TigoG/Minor_Smart_Things/design/architecture/ArchitectureDesign/Architecture Design.png

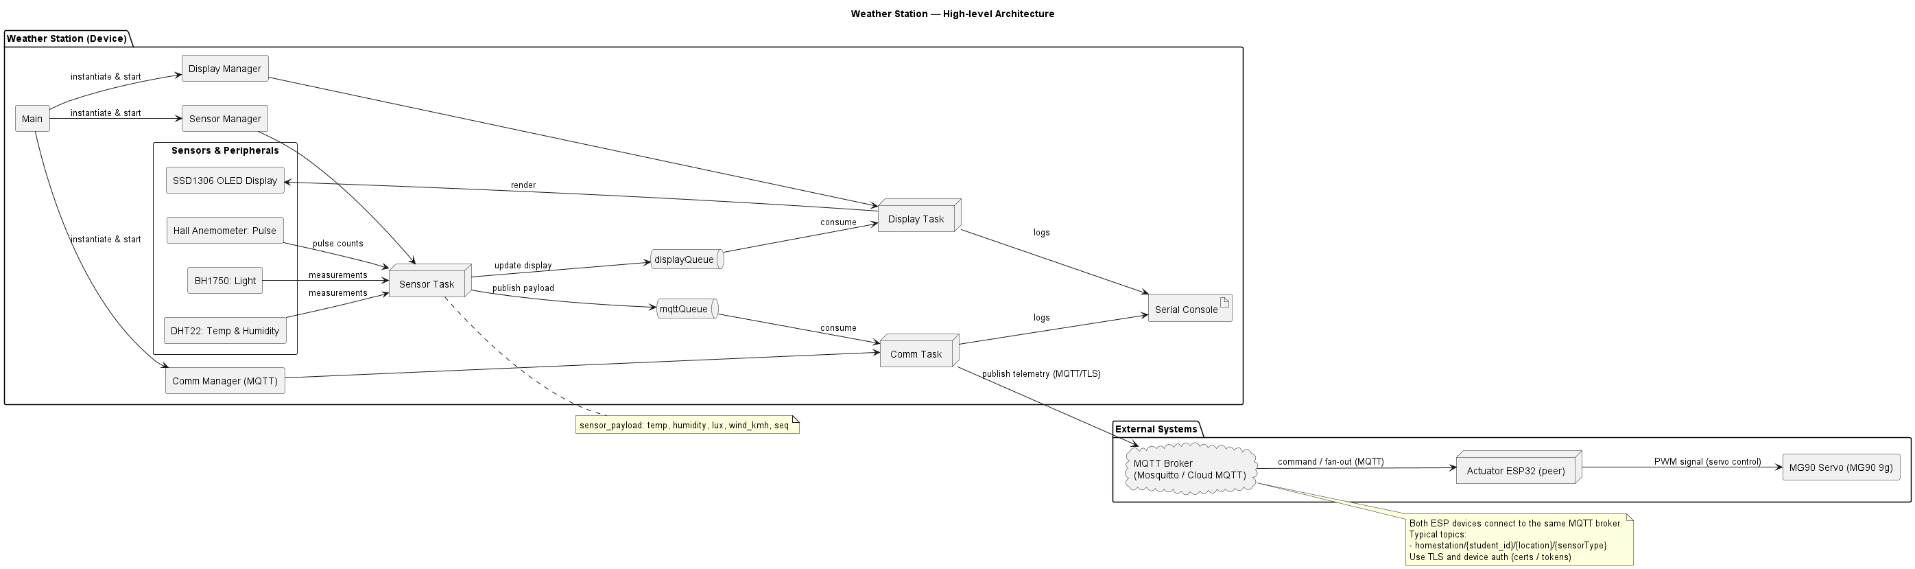
design/architecture/ArchitectureDesign/Architecture Design.png
