TigoG/Minor_Smart_Things/out/design/architecture/ArchitectureDesign/Architecture Design.png

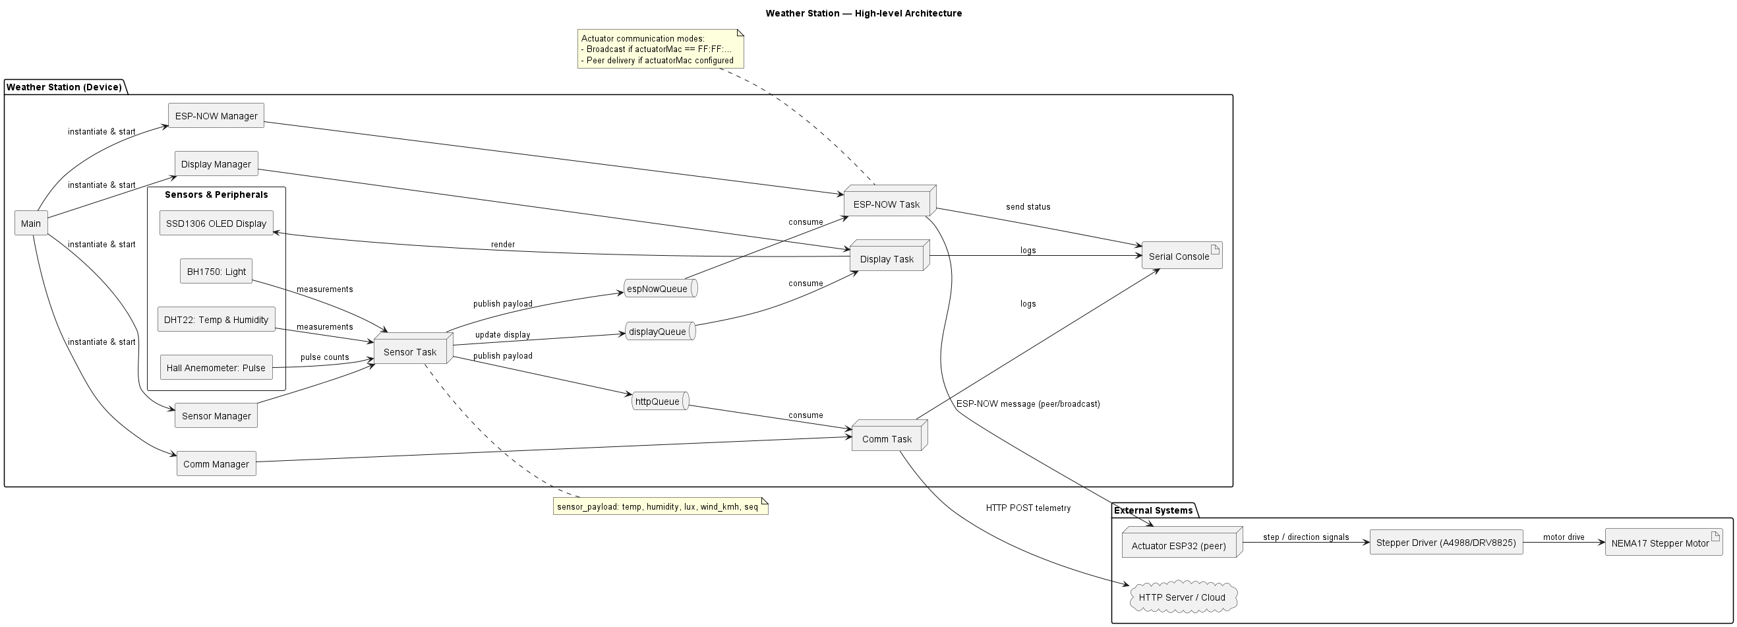
out/design/architecture/ArchitectureDesign/Architecture Design.png
