TigoG/Minor_Smart_Things/weatherStation/src/managers/SensorManager.cpp

#include "SensorManager.h"
#include "Common.h"
#include <Arduino.h>
#include <cmath>
#include <Wire.h>
#include <BH1750.h>
#include <freertos/FreeRTOS.h>
#include <freertos/task.h>

//
// Local ISR state (kept private to this translation unit)
//
volatile uint32_t pulseCount = 0;
volatile uint32_t lastPulseMicros = 0;

IRAM_ATTR void hallISR() {
  uint32_t now = micros();
  if (now - lastPulseMicros > 1000) {
    pulseCount++;
    lastPulseMicros = now;
  }
}

static BH1750 lightMeter;

SensorManager::SensorManager(uint32_t intervalMs)
  : _intervalMs(intervalMs), _seq(0) {}

void SensorManager::begin() {
  Wire.begin(SDA_PIN, SCL_PIN);

  // Scan I2C for BH1750 on common addresses (0x23 and 0x5C) and attempt init.
  Serial.println("Scanning I2C for BH1750...");
  uint8_t candidate_addrs[] = { BH1750_ADDR, 0x5C };
  uint8_t foundAddr = 0;
  size_t naddrs = sizeof(candidate_addrs) / sizeof(candidate_addrs[0]);
  for (size_t i = 0; i < naddrs; ++i) {
    uint8_t addr = candidate_addrs[i];
    Wire.beginTransmission(addr);
    uint8_t ack = Wire.endTransmission();
    if (ack == 0) {
      Serial.printf("I2C device responds at 0x%02X\n", addr);
      foundAddr = addr;
      break;
    } else {
      Serial.printf("No I2C ack at 0x%02X (err=%d)\n", addr, ack);
    }
  }

  bool bhOk = false;
  if (foundAddr) {
    // Pass explicit address and Wire instance to the BH1750 library to avoid address ambiguity.
    bhOk = lightMeter.begin(BH1750::ONE_TIME_HIGH_RES_MODE, foundAddr, &Wire);
    if (bhOk) {
      Serial.printf("BH1750 init OK at 0x%02X (one-shot)\n", foundAddr);
    } else {
      Serial.printf("BH1750 init failed at 0x%02X\n", foundAddr);
    }
  } else {
    // Try default address from Common.h, then library default as fallback.
    if (lightMeter.begin(BH1750::ONE_TIME_HIGH_RES_MODE, BH1750_ADDR, &Wire)) {
      Serial.printf("BH1750 init OK at default addr 0x%02X\n", BH1750_ADDR);
      bhOk = true;
    } else if (lightMeter.begin(BH1750::ONE_TIME_HIGH_RES_MODE)) {
      Serial.println("BH1750 init OK (library default)");
      bhOk = true;
    } else {
      Serial.println("BH1750 init failed (no BH1750 found)");
    }
  }

  delay(200);

  // DHT22 handled by manual bit-banged reader; no library init required
  pinMode(HALL_PIN, INPUT_PULLUP);
  attachInterrupt(digitalPinToInterrupt(HALL_PIN), hallISR, FALLING);

  if (!espNowQueue) espNowQueue = xQueueCreate(5, sizeof(sensor_payload_t));
  if (!httpQueue) httpQueue = xQueueCreate(5, sizeof(sensor_payload_t));
  if (!displayQueue) displayQueue = xQueueCreate(1, sizeof(sensor_payload_t));

  xTaskCreatePinnedToCore(&SensorManager::taskEntry, "SensorTask", 4096, this, 2, NULL, 1);
}

void SensorManager::taskEntry(void* pv) {
  static_cast<SensorManager*>(pv)->task();
}

void SensorManager::task() {
  for (;;) {
    uint32_t start = millis();

    noInterrupts();
    uint32_t pulses = pulseCount;
    pulseCount = 0;
    interrupts();

    // Use pulses per second and apply calibration to convert to km/h:
    // Calibration (logarithmic fit from calibration curve):
    //   wind_kmh = 6.4056 * ln(pulses_per_sec) + 10.212   (R^2 = 0.9914)
    float pulses_per_sec = (float)pulses / (_intervalMs / 1000.0f);
    float wind_kmh;
    // Treat tiny pulse rates as zero (noise floor)
    if (pulses_per_sec < 0.05f) {
      wind_kmh = 0.0f;
    } else {
      // Use natural logarithm; clamp negative results to zero
      float fitVal = 6.4056f * logf(pulses_per_sec) + 10.212f;
      wind_kmh = (fitVal > 0.0f) ? fitVal : 0.0f;
    }
    // Legacy physical conversion (kept as reference):
    // const float PI_f = 3.14159265358979323846f;
    // float linear_speed_m_s = (pulses_per_sec / (float)PULSES_PER_REV) * (2.0f * PI_f * ANEMOMETER_RADIUS_M);
    // float wind_kmh = linear_speed_m_s * 3.6f;
    
    float tempC, humidity;
    if (!readDHT22(tempC, humidity)) {
      tempC = NAN;
      humidity = NAN;
    }
    float lux = readLuxBH1750();
    
    sensor_payload_t payload;
    payload.tempC = tempC;
    payload.humidity = humidity;
    payload.lux = lux;
    payload.wind_kmh = wind_kmh;
    payload.seq = ++_seq;

    Serial.printf("Sensor: seq=%u temp=%0.1f hum=%0.1f wind=%0.2f km/h lux=%0.1f\n",
                  payload.seq,
                  isnan(payload.tempC) ? NAN : payload.tempC,
                  isnan(payload.humidity) ? NAN : payload.humidity,
                  payload.wind_kmh,
                  isnan(payload.lux) ? NAN : payload.lux);

    // Publish to queues (non-blocking)
    if (espNowQueue) xQueueSend(espNowQueue, &payload, 0);
    if (httpQueue) xQueueSend(httpQueue, &payload, 0);
    if (displayQueue) xQueueOverwrite(displayQueue, &payload);

    // Sleep until next measurement window
    uint32_t elapsed = millis() - start;
    if (elapsed < _intervalMs) vTaskDelay(pdMS_TO_TICKS(_intervalMs - elapsed));
  }
}

bool SensorManager::readDHT22(float &tempC, float &humidity) {
  uint8_t data[5] = {0,0,0,0,0};

  // Send start signal: pull low >800us, then release
  pinMode(DHTPIN, OUTPUT);
  digitalWrite(DHTPIN, LOW);
  delayMicroseconds(1100); // >800us to ensure sensor registers the start
  digitalWrite(DHTPIN, HIGH);
  delayMicroseconds(30);
  pinMode(DHTPIN, INPUT_PULLUP);

  noInterrupts();

  uint32_t t = micros();

  // Wait for sensor response: LOW (~80us)
  while (digitalRead(DHTPIN) == HIGH) {
    if (micros() - t > 1000) { interrupts(); pinMode(DHTPIN, INPUT_PULLUP); return false; }
  }

  // Wait for response: HIGH (~80us)
  t = micros();
  while (digitalRead(DHTPIN) == LOW) {
    if (micros() - t > 1000) { interrupts(); pinMode(DHTPIN, INPUT_PULLUP); return false; }
  }

  // Read 40 bits (5 bytes)
  for (int i = 0; i < 40; ++i) {
    // Wait for start of the bit (line goes LOW)
    t = micros();
    while (digitalRead(DHTPIN) == HIGH) {
      if (micros() - t > 1000) { interrupts(); pinMode(DHTPIN, INPUT_PULLUP); return false; }
    }

    // Wait for the line to go HIGH - start of the data bit
    t = micros();
    while (digitalRead(DHTPIN) == LOW) {
      if (micros() - t > 1000) { interrupts(); pinMode(DHTPIN, INPUT_PULLUP); return false; }
    }

    // Measure length of the HIGH signal; > ~40us means '1'
    uint32_t startHigh = micros();
    while (digitalRead(DHTPIN) == HIGH) {
      if (micros() - startHigh > 200) break;
    }
    uint32_t highLen = micros() - startHigh;

    data[i/8] <<= 1;
    if (highLen > 40) data[i/8] |= 1;
  }

  interrupts();

  // Validate checksum
  uint8_t sum = data[0] + data[1] + data[2] + data[3];
  if (sum != data[4]) {
    pinMode(DHTPIN, INPUT_PULLUP);
    return false;
  }

  uint16_t rawHumidity = ((uint16_t)data[0] << 8) | data[1];
  uint16_t rawTemp = ((uint16_t)data[2] << 8) | data[3];

  humidity = rawHumidity / 10.0f;
  if (rawTemp & 0x8000) {
    rawTemp &= 0x7FFF;
    tempC = -((int16_t)rawTemp) / 10.0f;
  } else {
    tempC = rawTemp / 10.0f;
  }

  pinMode(DHTPIN, INPUT_PULLUP);
  return true;
}

float SensorManager::readLuxBH1750() {
  // One-shot measurement: wait for ready then read
  float lux = NAN;

  // Wait (blocking) until measurement is ready. Pass true to allow maxWait which will yield.
  if (!lightMeter.measurementReady(true)) {
    Serial.println("BH1750: measurement not ready");
    // Reconfigure for next measurement
    lightMeter.configure(BH1750::ONE_TIME_HIGH_RES_MODE);
    return NAN;
  }

  lux = lightMeter.readLightLevel();
  if (lux < 0.0f) {
    Serial.printf("BH1750: readLightLevel returned %0.2f\n", lux);
    lightMeter.configure(BH1750::ONE_TIME_HIGH_RES_MODE);
    return NAN;
  }

  // Reconfigure for next one-shot measurement
  lightMeter.configure(BH1750::ONE_TIME_HIGH_RES_MODE);

  // 5-sample moving average with basic sanity/clamp checks
  static const int BUF_SIZE = 5;
  static float buf[BUF_SIZE] = {NAN, NAN, NAN, NAN, NAN};
  static int idx = 0;
  static int count = 0;
  static float sum = 0.0f;

  if (!isnan(lux) && (lux >= 0.0f)) {
    // Clamp to plausible BH1750 range
    if (lux < 0.0f || lux > 120000.0f) {
      // invalid reading, return previous average if available
      if (count > 0) return sum / (float)count;
      return NAN;
    }

    // basic spike rejection: if we have previous avg and new lux is > 10x avg and > 10000, ignore it
    if (count > 0) {
      float avg = sum / (float)count;
      if (lux > avg * 10.0f && lux > 10000.0f) {
        return avg;
      }
    }

    // add to circular buffer
    if (count < BUF_SIZE) {
      buf[idx] = lux;
      sum += lux;
      count++;
    } else {
      sum -= buf[idx];
      buf[idx] = lux;
      sum += lux;
    }
    idx = (idx + 1) % BUF_SIZE;
    return sum / (float)count;
  }

  // No data available: return previous average if any
  if (count > 0) return sum / (float)count;
  return NAN;
}
