TigoG/Minor_Smart_Things/weatherStation/include/DisplayManager.h

#ifndef MANAGERS_DISPLAYMANAGER_H
#define MANAGERS_DISPLAYMANAGER_H

#include "Common.h"

class DisplayManager {
public:
  DisplayManager();
  void begin();

private:
  static void taskEntry(void* pv);
  void task();
};

#endif // MANAGERS_DISPLAYMANAGER_H
