TigoG/Minor_Smart_Things/(commit log)

2025-09-25 Add initial project files including .gitignore, design specifications, BOM, calibration plan, and architecture diagram for the Minor Smart Things Weather Station.
2025-09-25 Add initial implementation of weather station firmware and project structure
    - Create main application file with setup and loop functions
    - Implement sensor management, communication, and display management classes
    - Add support for ESP-NOW and HTTP communication
    - Include necessary libraries and define project-specific constants
    - Set up .gitignore and README files for project organization
2025-10-02 Update .gitignore, add Bill of Materials and testing documentation, and refine main.cpp networking placeholders
2025-10-04 Fixed Lux sensor and ESP-now
    [CommManager.cpp, Common.h, DisplayManager.cpp, EspNowManager.cpp, SensorManager.cpp, main.cpp]
2025-10-06 Implement ShadeController and StepperController classes with sensor integration and command handling
2025-10-06 Update README.md for clarity and structure; remove outdated BOM documentation
2025-10-14 Refactor SensorManager to remove DHT library dependency and implement manual DHT22 reading
2025-10-30 Update pin definitions for DHT sensor and hall sensor in Common.h
2025-11-04 REmoved espnow handling in actuator and uses mqtt
2025-11-05 Lux sensor works now, All work
2025-11-06 Actuator uses mqtt server
2025-11-06 Updated design and added calibrationcurve
2025-11-08 added direct motor hadnling for mqtt
